anl2992019662-max/stm32-plant-care/docs/acceptance.md

# 实物验收表（待执行）

本表为空白测试方案，所有“待测”都尚未在硬件执行。不要用软件测试结果代填实测栏。记录日期、板卡/模块批次、固件SHA-256、测试条件、仪器和原始日志；照片/视频应先去除姓名、学号等个人信息，再决定是否公开。

| 编号 | 操作 | 验收依据 | 实测结果 |
|---|---|---|---|
| H01 | 断电检查5V/3.3V、极性、地线和负载电流路径 | 无短路，模拟输入不超3.3V，驱动栅极有下拉 | 待测 |
| H02 | 仅接主控与OLED，启动/复位10次 | 每次手动、输出请求归零；无随机开泵 | 待测 |
| H03 | SWD识别并写入、校验 | 真实C8/64KiB，写入校验通过，日志含固件哈希 | 待测 |
| H04 | 用示波器/分析仪测UART、PWM、1-Wire | UART9600容差满足模块要求；PWM约50Hz，脉宽符合设置；单总线符合DS18手册 | 待测 |
| H05 | DS18接入、拔出、接回，与参考温度计对比 | 有效读数稳定；拔出后≤3秒失效；误差按器件规格与仪器不确定度评估 | 待测 |
| H06 | 两路ADC分别施加稳定安全电压及标定端点 | raw稳定，中值可抑制孤立异常；0/100%符合端点，近电源轨失效 | 待测 |
| H07 | CO₂上电预热、正常回应、拔串口、重接 | 180秒前null；校验有效才更新；断开后过期，不显示旧数据为新值 | 待测 |
| H08 | 四键短/长按、设置页、保存后复位 | 去抖、模式选择、保存与标定状态符合说明，复位不恢复输出 | 待测 |
| H09 | 各GPIO用LED/逻辑探头空载测试 | 高电平开、低电平关；开机复位始终保持预期低电平 | 待测 |
| H10 | 逐路接风扇/灯/泵，测启动及稳态电流 | 不超过器件、线材和电源额定；主控不复位；CO₂供电在对应型号范围内 | 待测 |
| H11 | 舵机卸载、再接遮阳机构 | 两位置无机械顶死、不卡线、不堵转，断电可人工释放 | 待测 |
| H12 | 泵默认3秒连续运行，连续重复ON请求 | 软件输出持续时间不超过配置值+测得最长循环延时；目标先检查超时误差≤50ms，超出需分析并修正；记录水流滞后 | 待测 |
| H13 | 泵运行中断开浮球，重新接回 | 在一轮控制更新后停泵，目标≤50ms；重接不绕过60秒冷却 | 待测 |
| H14 | 泵运行中断开土壤传感，测试正常/异常电压 | 可识别的无效/过期输入会停泵；记录正常电压范围内不可识别的故障 | 待测 |
| H15 | 自动干燥场景连续请求 | 单次时长、60秒停止间隔、15秒每小时预算均生效；不连续灌溉 | 待测 |
| H16 | 手机/电脑REMOTE控制，终止PING或物理断链 | 最后有效活动10秒后归零并回手动，误差≤一轮控制更新 | 待测 |
| H17 | 人工制造温度/光照阈值附近变化 | 回差区间无快速反复切换；灯与遮阳互斥 | 待测 |
| H18 | 配置保存/重新上电；台架在保存中断电 | 读取完整新配置或旧配置；两页均无效则默认且未标定，不自动启动 | 待测 |
| H19 | 设置TIME，LSE/LSI及VBAT保持测试 | UTC设置有效；记录24小时实际误差；按时钟源核对断电行为 | 待测 |
| H20 | 暂停主循环（测试固件），制造OLED总线占用 | 看门狗可恢复到手动；OLED异常不会无限阻塞；记录复位时间 | 待测 |
| H21 | 8小时有人巡检，再48小时台架老化 | 记录复位、错误计数、负载温升、供电、每次浇水体积；无数据不能写“稳定运行” | 待测 |

主控看门狗计时采用LSI，精确复位间隔未测，不能按标称2秒当作硬件保证。泵本体停转、管路排水和虹吸还需单独观察。演示用CO₂报警不得作为人员安全判断依据。

## 记录模板

```text
日期 / 操作人代号：
板卡与模块型号 / 供电：
固件 SHA-256 / 修改项：
测试编号 / 前置条件：
操作与仪器：
预期 / 实测 / 原始日志位置：
通过 / 失败 / 未测：
失败原因与修复后复测：
```

## 分阶段搭建

1. 先买主控、ST-Link、OLED、DS18、两路模拟模块，完成烧录、显示和采样。
2. 再接CO₂与HC-05，验证预热、帧校验、断线、串口控制。
3. 负载先用LED代替，测试复位和超时；再逐路接MOSFET、浮球及真实小功率负载。
4. 最后做舵机机构、水路防虹吸、供电峰值和连续运行。每阶段失败先修正，不直接跳到无人值守浇水。
