anl2992019662-max/stm32-plant-care/docs/images/README.md

# 绿植养护配图说明

三张 PNG 是 AI 生成的设计参考，均非实物照片；提示词、哈希及说明见 [sources.json](sources.json)。四张 SVG 是根据现有公开代码与硬件文档绘制的结构及控制流程。

生成图片的机械外观、屏幕文字、组件造型和示意线路不作为工程规格。具体传感器、引脚、供电与驱动以 hardware/ 和 docs/ 中的文字、CSV 与参考接线图为准。当前并未完成样机制作或实物测试。
