anl2992019662-max/stm32-plant-care/hardware/bom.csv

item | reference | quantity | selection | notes
主控 | U1 | 1 | STM32F103C8T6核心板 | 64KiB Flash与20KiB RAM；引出SWD和所有指定GPIO
下载调试器 | JDBG | 1 | 正规ST-Link或兼容SWD探针 | VTref与供电功能按探针手册确认
温度 | U2 | 1 | DS18B20 | 外部3.3V供电；封装和线序以实物为准
土壤 | U3 | 1 | 3.3V电容式模拟土壤传感模块 | AO不得超3.3V；不把百分比当体积含水率
光照 | U4 | 1 | 3.3V模拟光照模块 | AO模拟输出；不是仅DO的比较器板
二氧化碳 | U5 | 1 | MH-Z19C或已有的MH-Z19B | 正规来源；C型供电5.0±0.1V；B型已停产
蓝牙 | U6 | 1 | HC-05经典蓝牙SPP模块 | 确认底板供电与UART3.3V；数据模式9600
显示 | U7 | 1 | SSD1306 128x64 I2C OLED | 地址0x3C；3.3V供电与上拉；不选SH1106替代
舵机 | M4 | 1 | SG90 | 独立5V支路；先卸载标定行程与峰值电流
水泵 | M1 | 1 | 5V小功率直流水泵及水管 | 核对启动和堵转电流；水路防虹吸
风扇 | M2 | 1 | 5V双线直流风扇 | 核对启动电流与气流方向
补光 | L1 | 1 | 5V自带限流LED模块 | 光谱和功率按植物实验另行验证；不使用裸LED
蜂鸣器 | BZ1 | 1 | 5V有源蜂鸣器 | 通过MOSFET驱动；磁性负载加续流保护
水位 | SW_WATER | 1 | 干接点浮球开关 | 有水闭合接GND；断线停泵；实测安装方向
按键 | K1-K4 | 4 | 独立常开按键 | 一端指定GPIO一端GND
驱动 | Q1-Q4 | 4 | AO3400A或支持3.3V逻辑的MOSFET驱动模块 | 有下拉和续流保护；按实际电流和散热降额
栅极电阻 | R1-R4 | 4 | 100欧 | 每路串联GPIO至Gate；模块已带则不重复
栅极下拉 | R5-R8 | 4 | 10k欧 | 每路Gate至Source/GND；复位期间保持关闭
单总线上拉 | R9 | 1 | 4.7k欧 | PB5至3.3V
I2C上拉 | R10-R11 | 2 | 4.7k欧 | PB6/PB7至3.3V；模块已带需核对并联等效值
ADC滤波 | R12-R13 | 2 | 1k欧 | 模拟输出串入ADC；配100nF至地并验证稳定性
续流 | D1-D3 | 3 | 按负载峰值选型的肖特基二极管 | 参考SS34；泵风扇磁性蜂鸣器阴极接+5V
去耦 | C1-C3 | 3 | 470uF或100uF低压电解 | 舵机470uF和CO2/主控100uF参考；核对极性耐压
去耦 | C4-C10 | 7 | 100nF陶瓷 | 各模块及ADC就近布置；数量按实物调整
电源 | PS1 | 1 | 稳定5V外部电源 | 4A仅设计起点；按总启动堵转电流核算并测压降
保护 | F1-SW1 | 1 | 合适保险丝与负载电源开关 | 额定值根据线材和实测电流确定
机构 | MECH | 1 | 遮阳帘支架水箱水管和防滴固定件 | 尺寸按实际模块设计；尚无加工件
RTC备份 | BAT1 | 0 | 可选CR2032与32.768kHz晶振板载方案 | 先确认VBAT没有短接3.3V；禁止充电
