anl2992019662-max/stm32-plant-care/docs/validation.md

# 本机验证报告

验证日期：2026-10-19。状态：软件参考版本，待实物验收。所有结果仅对应当前源码和 `release/manifest.json` 标识的固件，不能外推为已经完成硬件运行。

| 项目 | 实际结果 |
|---|---|
| 完整固件编译、链接、HEX/BIN导出 | Arm Compiler for Embedded 6.24成功；最终构建0警告、0错误 |
| 程序占用 | BIN 12,456字节，限制63,488字节（62KiB），未占用配置页 |
| RAM静态布局 | 数据3,324字节，加独立4,096字节栈，共7,420字节；20KiB内，不表示已测最大栈深 |
| 启动与镜像结构 | SP=`0x20005000`，Thumb复位向量，栈区UNINIT，HEX校验及HEX/BIN逐字节一致性检查 |
| 可移植C核心 | 11组通过：模式/标定、回差/过期、泵时限/冷却、预算/STOP计账、租约/计数回绕、非法指令、行溢出、传感解析、配置CRC、遥测null、随机状态约束 |
| 随机状态检查 | 固定种子50,000步；检查泵许可、单次时长、预算及灯/遮阳互斥；不是硬件故障概率测量 |
| 电脑端自动测试 | 5项通过：遥测/单位、坏帧、指令注入拒绝、故障解释、同一C核心的端到端模拟 |
| Tk界面检查 | 控件创建通过；隐藏界面实际连接C模拟进程，检查温度卡片、自动风扇/泵、缺水停泵和关闭通过 |
| 上游依赖 | 固定版本ST/Arm文件逐一SHA-256检查，原许可保留 |
| 隐私检查 | 发布范围不含原计划书、PDF、个人文档、日志或凭据文件；定向密钥模式扫描未发现命中，不能保证检测所有形式的秘密 |

C本机测试由官网Zig 0.15.2提供的本机C编译器构建，断言明确开启；不是用Python重新写一份控制规则后测试自己。Python的演示通过适配器调用同一C源码。软件演示绕过CO₂预热和实体标定，只注入数据和时间。

Keil工程的文件路径、源码集合和scatter引用另有一致性检查。**uVision图形界面批量构建在当前环境异常退出，原因未定位，不把该路径列为已验证成功。** 上表成功构建来自已实际运行的 `tools/build_keil.py`，直接调用同一安装中的官方Arm编译器和连接器。首次使用Keil图形界面时仍应核对本机工具链、Device Pack与工程设置；可以直接使用已验证的脚本构建。

GitHub Actions文件只配置了Linux便携C/协议测试及交付完整性检查。首次在线运行前不宣称CI已通过，也不在CI中模拟真实硬件或分发商业编译器。

## 尚未完成的验证

板级ADC精度、单总线/I²C/UART电气时序、OLED显示实物、按键、Flash掉电耐受、RTC误差及备份、蓝牙手机兼容性、舵机角度、驱动散热、负载电流、主循环最长周期、故障响应实测时间、水泵实际出水量、防虹吸、48小时稳定性及植物对照实验，全部待测。步骤见[硬件验收表](acceptance.md)。

没有原型实拍、实测曲线或已制造PCB。接线图是参考设计，不能把软件演示作为这些证据。后续拿到硬件后，发现与参考假设不同的模块应先修正引脚/电平/驱动，再运行验收。

## 复现

```powershell
python tools/build_keil.py --bin "C:\Keil_v5\ARM\ARMCLANG\bin"
python tools/test.py --cc '"C:\Tools\zig\zig.exe" cc'
python tools/verify.py
python desktop/app.py --demo
```

完整通过记录见 `release/test-results.txt`。固件和与其对应的源码/依赖哈希见 `release/manifest.json`。修改源码后应重新编译、测试和生成发布清单，不能继续把旧固件称作新源码的构建结果。
