anl2992019662-max/stm32-plant-care/(commit log)

2026-10-19 Build STM32 plant care reference project
    [bom.csv, pinout.csv]
2026-10-19 更新 README.md
